fbmasutti/GapEscapeGame/IMAGENS/Escapa1.jpg

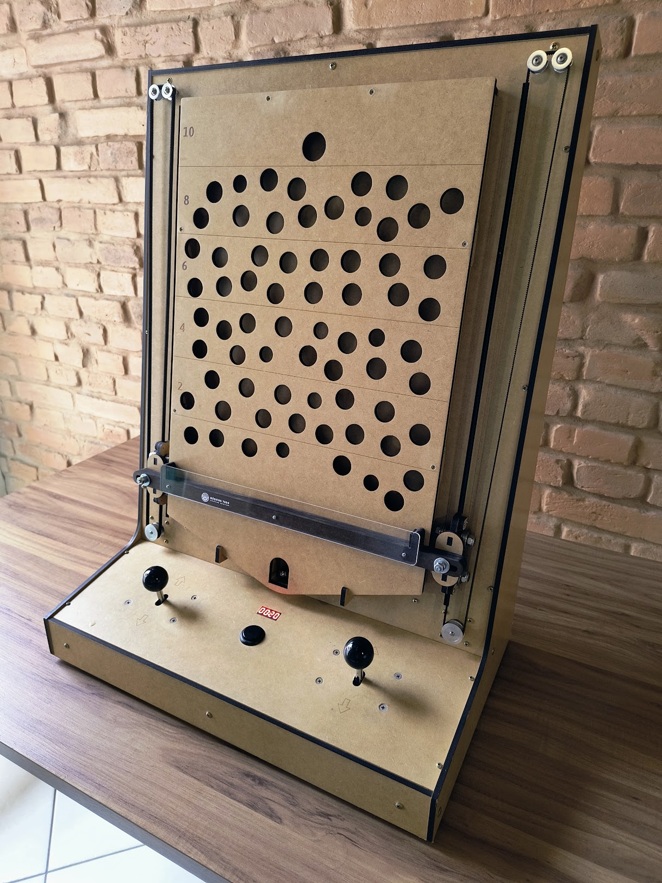
IMAGENS/Escapa1.jpg
