fbmasutti/GapEscapeGame/README.md

# GapEscapeGame

# Escapa Buraco Arcade

Um projeto open-source inspirado nos clássicos jogos eletromecânicos de habilidade como *Ice Cold Beer* e *Zeke's Peak*. O objetivo é construir uma máquina arcade em MDF com controle por joysticks, utilizando eletrônica baseada em Arduino e componentes maker acessíveis. :contentReference[oaicite:0]{index=0}

## O projeto

O Escapa Buraco Arcade foi desenvolvido pelo **Coletivo Máquina Tudo** como uma plataforma aberta para estudos, fabricação digital e experimentação em eletrônica, marcenaria e programação. A estrutura foi projetada para corte a laser em MDF, com alguns acabamentos manuais na versão 1.0. :contentReference[oaicite:1]{index=1} :contentReference[oaicite:2]{index=2}

## Conteúdo do repositório

- Arquivos para corte a laser
- Firmware para Arduino
- Manual de montagem
- Documentação da eletrônica
- Lista de materiais

## Licença

Este projeto é distribuído sob a licença **Creative Commons CC BY-NC 4.0**.

Você pode:
- Compartilhar e modificar o projeto;
- Criar versões derivadas para uso pessoal e educacional.

Você deve:
- Dar os créditos ao **Coletivo Máquina Tudo**;
- Indicar quando realizar modificações.

Você não pode:
- Comercializar este projeto ou versões derivadas sem autorização prévia. :contentReference[oaicite:3]{index=3}

## Apoie o projeto

Se este projeto foi útil para você, considere apoiar o desenvolvimento do Coletivo Máquina Tudo para que novos projetos open-source possam continuar sendo publicados.


Pix (https://fbmasutti.github.io/PixFront)

---

Projeto desenvolvido por **Leonardo Gallep** e **Fabrício Masutti** — Coletivo Máquina Tudo.
