fbmasutti/GapEscapeGame/SOFTWARE/Imagens/Pinagem Arduino CNC Shield.png

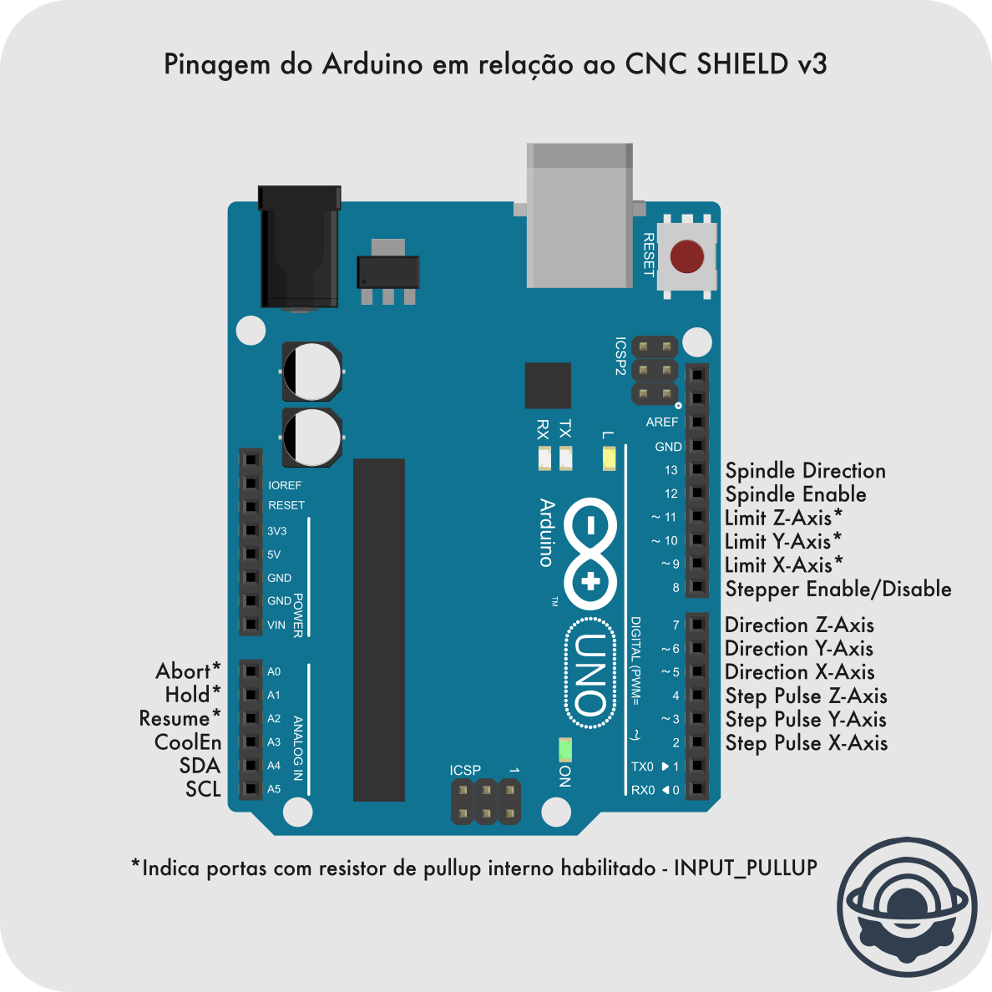
SOFTWARE/Imagens/Pinagem Arduino CNC Shield.png
