fbmasutti/GapEscapeGame/MÁQUINA TUDO_ESCAPA BURACO ARCADE V1.0 - PLANO DE CORTE_ACRÍLICO.pdf

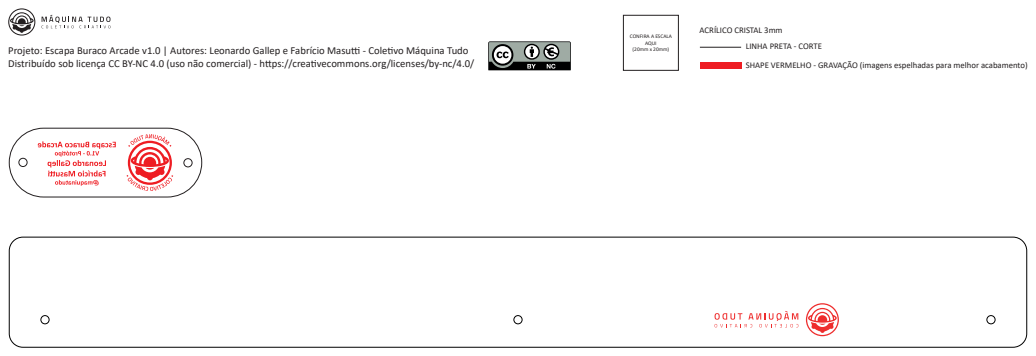
[picture p3: page 1]
CONFIRA A ESCALA AQUI (20mm x 20mm); ACRÍLICO CRISTAL 3mm

Projeto: Escapa Buraco Arcade v1.0 | Autores: Leonardo Gallep e Fabrício Masutti - Coletivo Máquina Tudo
Distribuído sob licença CC BY-NC 4.0 (uso não comercial) - https://creativecommons.org/licenses/by-nc/4.0/

LINHA PRETA - CORTE
SHAPE VERMELHO - GRAVAÇÃO (imagens espelhadas para melhor acabamento)
