fbmasutti/GapEscapeGame/MÁQUINA TUDO_ESCAPA BURACO ARCADE V1.0 - PLANO DE CORTE_MDF.pdf

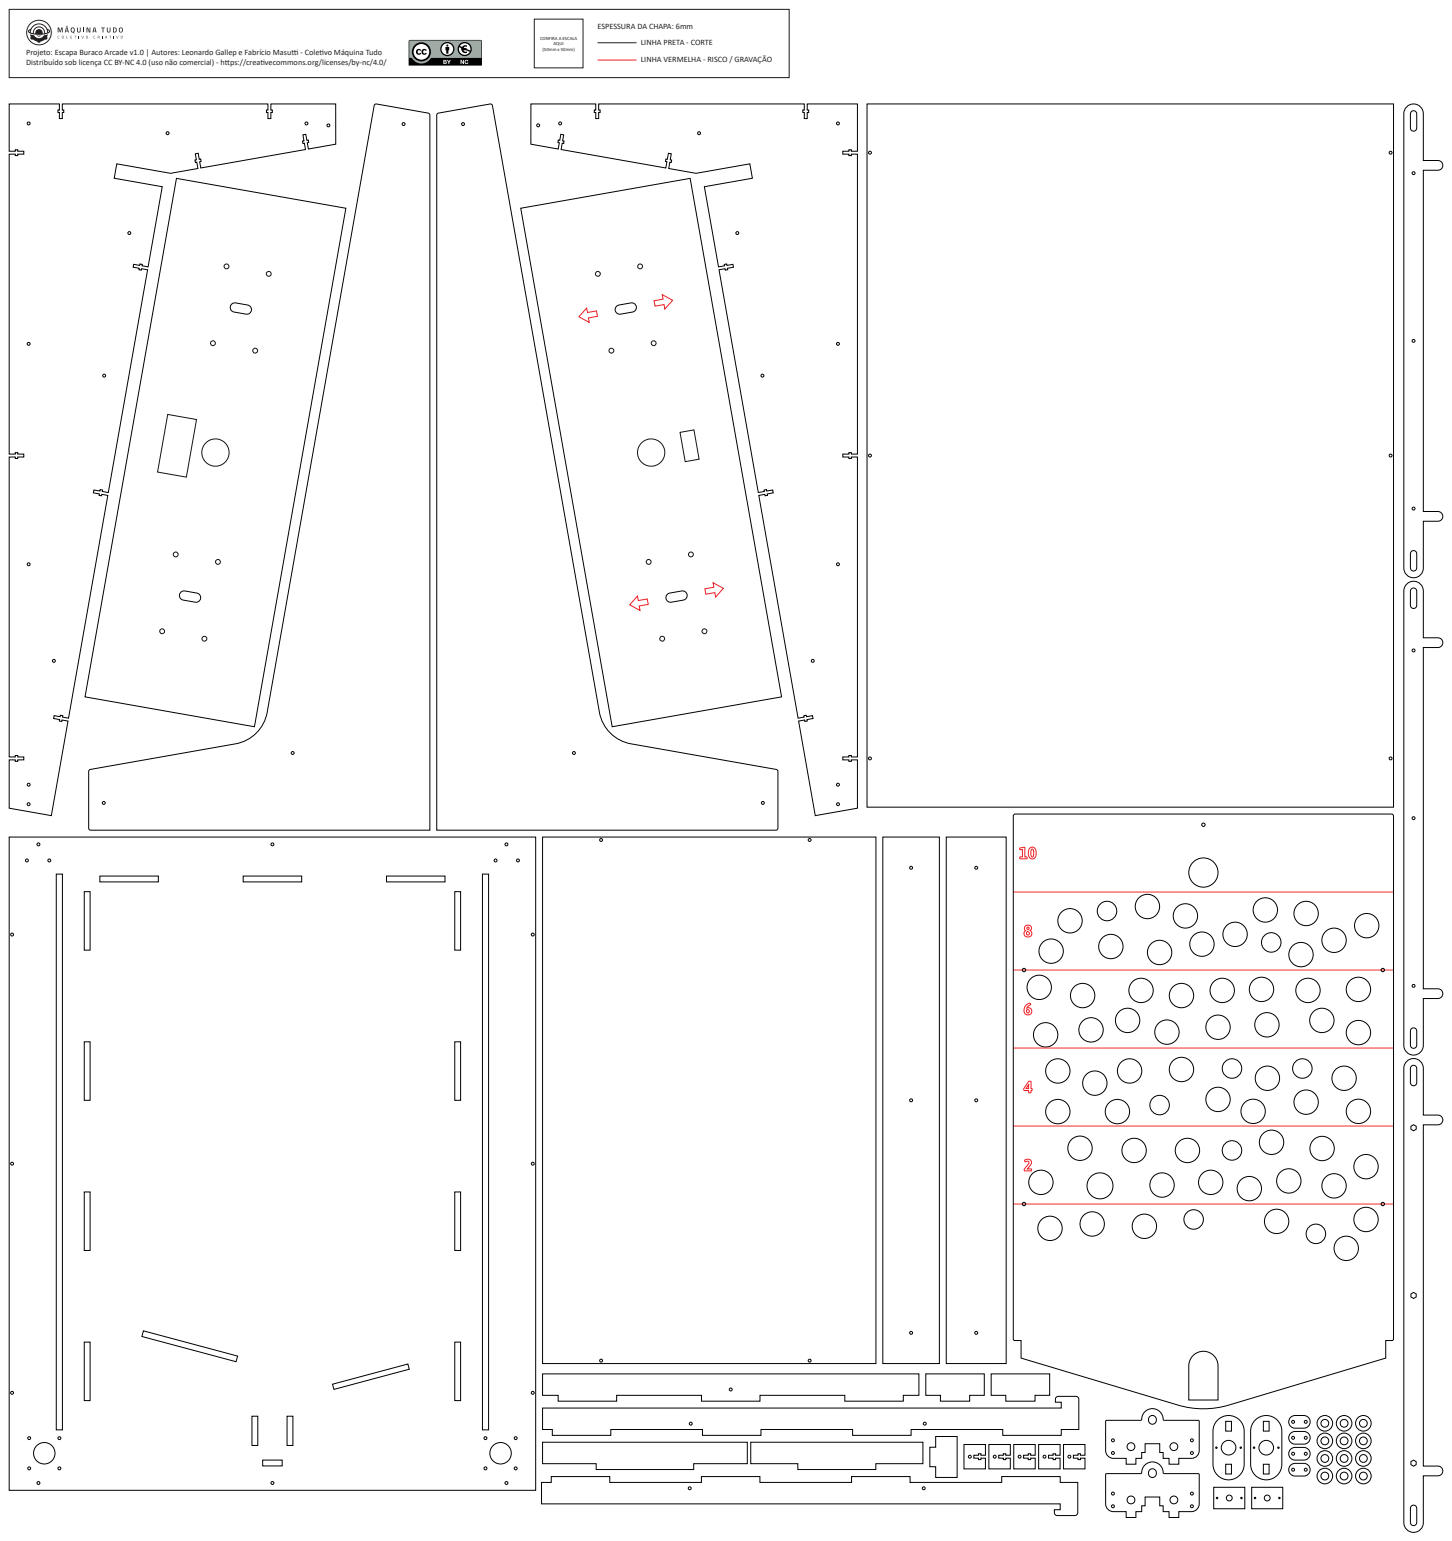
[picture p4: page 1]
CONFIRA A ESCALA AQUI (50mm x 50mm)

ESPESSURA DA CHAPA: 6mm

LINHA PRETA - CORTE
LINHA VERMELHA - RISCO / GRAVAÇÃO

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
